cgreen18/Gas-Chromatography/README.md

# Gas Chromatography Capstone Project
The senior capstone project by Conor Green and Matt McPartlan to fulfill degree requirements for a B.S. in Electrical Engineering at Loyola Marymount University. The objective is to design a economic, diode based gas chromatography (GC) detector. As part of the requirements of a capstone project, we created a [website](https://gaschromatographycapstone.wordpress.com/), with weekly updates.

## Background on Gas Chromatography
Matt has written a great explanation and justification for this project in the document "[Introduction to Chromatography](https://github.com/cgreen18/Gas-Chromatography/blob/master/Documentation/Introduction%20to%20Chromatography.pdf)."

## Three Main Components 
* [Analog voltage measurement](https://github.com/cgreen18/Gas-Chromatography/tree/master/Voltage%20Measurement)
* [Heating](https://github.com/cgreen18/Gas-Chromatography/tree/master/Heating)
* [Analog to digital conversion (ADC)](https://github.com/cgreen18/Gas-Chromatography/tree/master/ADC)

## Additional Requirements
* [Graphical user interface (GUI)](https://github.com/cgreen18/Gas-Chromatography/tree/master/GUI)
* ~~Auto-injector~~

## Installation
There are automatic installation and configuration scripts, install.sh and config.sh, respectively, located in the [Installation Folder](https://github.com/cgreen18/Gas-Chromatography/tree/master/Installation)

## Current Prototype
IMAGE MISSING

## Old Prototype
The shell of an old Gow-mac GC.
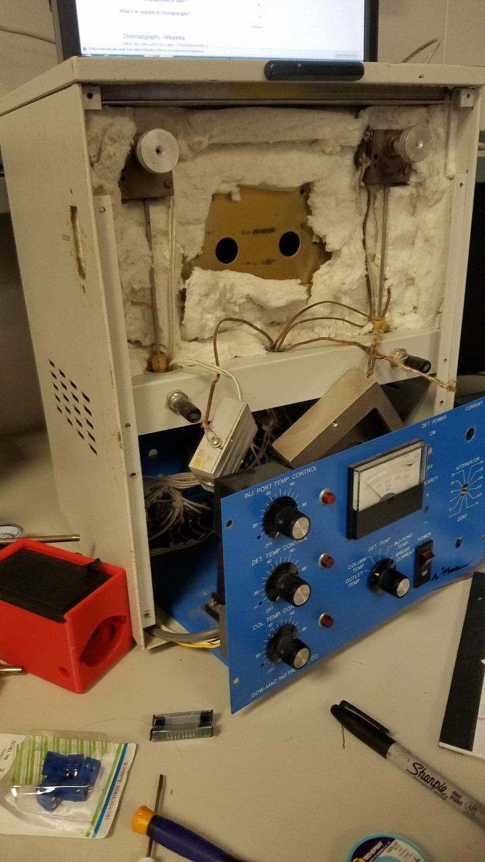
[picture p1: images/Galmac.jpg]
Gow-mac_Taken_Apart


## Team Member Biographies

#### Conor Green
> Conor Green is a Computer Engineering major at Loyola Marymount University, enrolled in the Honors College and pursuing a minor in Applied Mathematics. Every semester he has made Dean’s list and recently got invited and accepted into the engineering honor’s fraternity, Tau Beta Pi. Through the Honors department, Conor proposed, managed, and presented a $5000 research project on modifying the torque-slip characteristics of an induction motor through electro-plating that found significant results. Additionally, he was part of a team led by professor Dr. Huang to use computer vision to identify potholes from dash cam pictures in the Los Angeles area. Conor recently presented the induction motor and pothole research projects at This Is Honors and Undergraduate Research Symposium, respectively, at his university. In the summer of 2019 he participated in a NSF Research Experience for Undergraduates for Smart UAVs at Auburn University to model the interior of a building through Flash LiDAR without GPS. The results were novel and a technical report was written and published in the Computer Science and Software Engineering department of AU. In his senior year at LMU, Conor’s capstone project was to devise a cheap, easy-to-use, air or nitrogen based gas chromatography instrument. He plans on pursuing graduate school in Electrical Engineering with the intention of earning a Ph.D.

> Conor has consistently worked various jobs since he turned sixteen, including multiple summers of full time work and private and volunteer tutoring (mainly mathematics.) He has worked at his university’s bike shop, the Cycling Lion, since its inception and is starting his second year as a manager. Outside of academics and work, Conor is the Vice-President of his university’s rugby team and has participated in the UAV national competition SAE Aero West. He speaks Spanish fluently through classes and talking with close friends. Conor studied abroad in Madrid, Spain, for a semester his sophomore year.

#### Matt McPartlan
* coming shortly

## Acknowledgments
We would like to thank the Electrical Engineering and Computer Science and Chemistry departments at Loyola Marymount University for funding and support throughout the process. We would like to thank Dr. Hossein Asghari and Dr. Robert Senter for their advice and support as mentors. In particular, Dr. Senter has been on-board with the project since the inception 2 years ago and has provided tremendous help throughout.
