cgreen18/Gas-Chromatography/GUI/README.md

# GUI
Main folder for the software supporting the GC instrument.
This folder will probably moved to a folder with a better name in the final version.

### Versions
|Version | Date | Features |
|:---|:---|:---|
| 1.0 | 24 November 2019 | Initial Creation. |
| [2.0](https://github.com/cgreen18/Gas-Chromatography/tree/master/GUI/2.0) | 21 April 2020 | Successfully graphs live data with play button, graphs it live, saves images and .gc files, and clears. Basic, minimum GC supporting software. |
| [3.0](https://github.com/cgreen18/Gas-Chromatography/tree/master/GUI/3.0) | 24 April 2020 | Arduino serial interface. Temperature control and feedback thread. Normalize, integrate, and clean time menu functions. |
| 3.0+ | __future__ | Wrap up open parsing, data format, peaks. |
