cgreen18/Gas-Chromatography/Heating/README.md

# Oven, Injector, and Detector Heating Control

Increasing Delay gif

Example of Reducing Power Delivered to Element

## Breakdown of the System

### Triac Dimmer
Two [RoboDyn AC Light Dimmer](https://robotdyn.com/ac-light-dimmer-module-1-channel-3-3v-5v-logic-ac-50-60hz-220v-110v.html) were used to heat the elements: one dimmer for the oven and the other for the injector and detector together. This modules are triac based and as such, can clip the positive and negative waveforms. When the source voltage crosses zero, an interrupt is signalled for the microcontroller as seen in purple in the figure below. In this interrupt routine, the MCU delays some time then sends an ~8.33uS square pulse that allows the module to output the voltage to the load for the remainder of the wave as seen in green and blue in the figure below. 

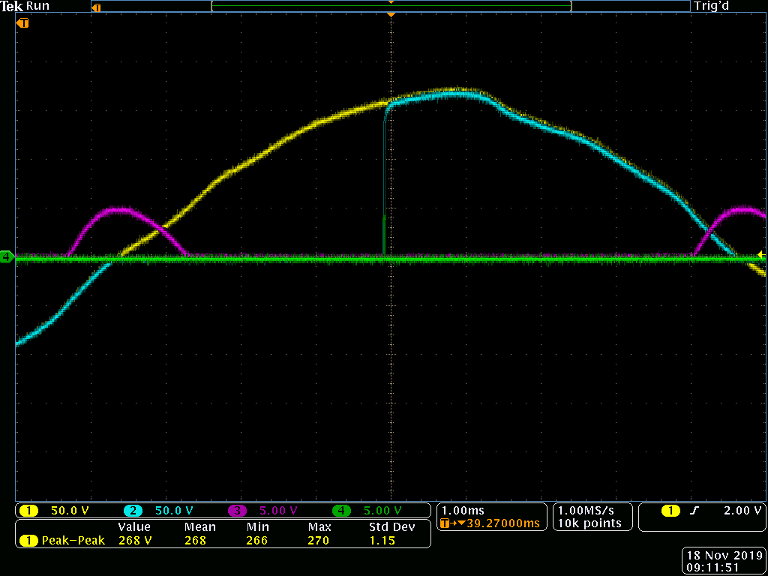
[picture p2: Heating/images/GC_TriacClipping_Oscilloscope_3.png]
Example Clip Oscilloscope


Legend:
* Yellow - Wall voltage = 120V @ 60Hz
* Blue - Load (heating element) voltage
* Purple - Zero-cross
* Green - Trigger square pulse

### Estimating Temperature
The voltage across the thermocouples is amplified by ~250 by an [LM358N](http://www.ti.com/product/LM358-N) as seen in the figure below.

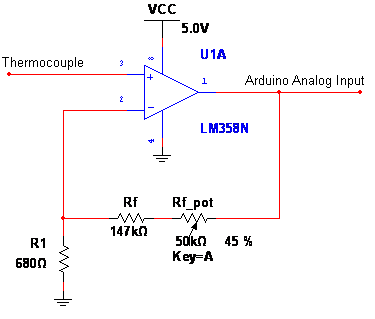
[picture p3: Heating/images/GC_ThermoAmp_SimpleCircuit_Snippet.png]
Non-inverting_amp


### PID Control
In order to achieve and maintain a desired temperature with little overshoot, a PID feedback loop was implemented with the triac output and the thermocouple temperature measurement. The output variable is the delay time before the square pulse is sent and the feedback variable is the amplified voltage from the thermocouples. The PID constants K<sub>p</sub>, K<sub>i</sub>, and K<sub>d</sub> will be tuned in the coming week.

PID_Diagram
Credit: Wikipedia @ [PID_Diagram_Link](https://en.wikipedia.org/wiki/PID_controller)
