cgreen18/Gas-Chromatography/ADC/README.md

# Directory for the Analog to Digital converter (ADC)
