cgreen18/Gas-Chromatography/GUI/4.0_Version/.images/README.md

# Current image directory set at the top of gc_gui.py
