cgreen18/Gas-Chromatography/Installation/Libraries.md

# Extra Libraries
### Important: All these must be install while the virtual environment is active
```
source /home/pi/.gc_venv/bin/activate
```

Update pip and tools for building a wheel (for use later)
```
pip install -U pip
pip install -U six wheel setuptools
```

Install some libraries
```
apt-get install libatlas-base-dev
```

More
```
pip3 install matplotlib
```

```
pip3 install pyyaml
```
