cgreen18/Gas-Chromatography/Installation/Extra.md

USB
```
sudo usermod -a -G dialout caravaggio
```
