cgreen18/Gas-Chromatography/(list of files, drawings)

Other design files:
Heating/Circuit Schematics/GC_ThermoAmp_SimpleCircuit_ConorMatt.ms13
Voltage Measurement/GC_AD620ANConfiguration.ms13
Voltage Measurement/GC_DiodeBiasing.ms13
Voltage Measurement/GC_ForwardVoltageDiffAmp.ms13
