cgreen18/Gas-Chromatography/Heating/three_element_heat_control.ino

/*  Title: three_element_heat_control.ino
 *  Author: Conor Green and Matt McPartlan
 *  Description: Reads injector, detector, and oven amplified thermocouple analog voltages... 
 *    and converts the values to temperature in Celcius. PID loop implemented using current...
 *    and target temperature.
 *  Usage: Upload to microcontroller with interrupt capability. Arduino Pro Micro 5V used.
 *  Version:
 *    1.0 - November 9 2019 - Initial creation.
 *    2.0 - November 11 2019 - Moved to one zero crossing interrupt
 */

// Constants - put in header/cpp later
// Max error from: minimum temp ~ 30C & max temp desired ~ 180 & small margin
float ERR_MAX = 160.0;

float K_P_OVEN = 0.98;
float K_I_OVEN = 0.01;
float K_D_OVEN = 0.01;

float K_P_INJ_DET = 0.98;
float K_I_INJ_DET = 0.01;
float K_D_INJ_DET = 0.01;

// Decision making variables
bool  x = true;

// Oven pins
int inter_oven = 2;
int triac_oven = 4;
int thermo_oven = A2;

// Oven variables (defaults)
unsigned int dim_oven = 1024;
float targ_oven = 150.0;
float temp_oven = 30.0;


// Injector and detector pins
int inter_inj_det = 3;
int triac_inj_det = 5;
int thermo_inj = A0;
int thermo_det = A1;

// Injector and detector variables
unsigned int dim_inj_det = 1024;
float targ_inj_det = 100.0;
float temp_inj = 30.0;
float temp_det = 30.0;

/*  Analog voltage to temperature conversion
 *  T = 58.3V + 39.2
 */

void setup() {
  Serial.begin(9600);
  
  pinMode(triac_inj_det,OUTPUT);
  pinMode(triac_oven,OUTPUT);
  attachInterrupt(digitalPinToInterrupt(inter_oven), zc_interrupt, RISING);
  //attachInterrupt(digitalPinToInterrupt(inter_inj_det), zc_inter_inj_det, RISING);
}

/*
void zc_inter_oven(){
  //Serial.println(dim_oven);
  dim_oven = 65*512;
  delayMicroseconds(dim_oven);
  digitalWrite(triac_oven,HIGH);
  delayMicroseconds(8.33);
  digitalWrite(triac_oven,LOW); 
}
*/

void zc_interrupt(){

  dim_oven = 5000;
  //dim_inj_det = (10000.0*/170);

  // oven >= inj_det + 8.33
  if(float diff = dim_oven - (dim_inj_det + 8.33) >=0){
    //float diff = dim_oven - (dim_inj_det + 8.33);

    Serial.println("Case 1");
    
    delayMicroseconds(dim_inj_det);
    digitalWrite(triac_inj_det,HIGH);
    delayMicroseconds(8.33);
    digitalWrite(triac_inj_det,LOW);
    delayMicroseconds(diff);
    digitalWrite(triac_oven,HIGH);
    delayMicroseconds(8.33);
    digitalWrite(triac_oven,LOW);
  }
  
  // inj_det + 8.33 >= oven > inj_det
  else if(float diff = dim_oven - dim_inj_det > 0){
    //float diff = dim_oven - dim_inj_det;
    
    Serial.println("Case 2");

    delayMicroseconds(dim_inj_det);
    digitalWrite(triac_inj_det,HIGH);
    delayMicroseconds(diff);
    digitalWrite(triac_oven,HIGH);
    delayMicroseconds(8.33-diff);
    digitalWrite(triac_inj_det,LOW);
    delayMicroseconds(diff);
    digitalWrite(triac_oven,LOW);
  }

  // inj_det >= oven +8.33
  else if(float diff = dim_inj_det - (dim_oven + 8.33) >= 0){
    //float diff = dim_inj_det - (dim_oven + 8.33);

    delayMicroseconds(dim_oven);
    digitalWrite(triac_oven,HIGH);
    delayMicroseconds(8.33);
    digitalWrite(triac_oven,LOW);
    delayMicroseconds(diff);
    digitalWrite(triac_inj_det,HIGH);
    delayMicroseconds(8.33);
    digitalWrite(triac_inj_det,LOW);    
  }

  // oven + 8.33 > inj_det >= oven 
  else if(float diff = dim_inj_det - dim_oven  >= 0){
    delayMicroseconds(dim_oven);
    digitalWrite(triac_oven,HIGH);
    delayMicroseconds(8.33-diff);
    digitalWrite(triac_inj_det,HIGH);
    delayMicroseconds(diff);
    digitalWrite(triac_oven,LOW);
    delayMicroseconds(8.33-diff);
    digitalWrite(triac_inj_det,LOW); 
  }
  
   
}

void update_temperatures(){
  int raw;
  raw = analogRead(thermo_oven);
  temp_oven = .284667*raw + 39.2;
  if(x){
    Serial.print("Oven temp: ");
    Serial.println(temp_oven);
  }
  raw = analogRead(thermo_inj);
  temp_inj = .284667*raw + 39.2;

  if(x){
    Serial.print("Injector temp: ");
    Serial.println(temp_inj);
  }

  raw = analogRead(thermo_det);
  temp_det = .284667*raw + 39.2;

  if(x){
    Serial.print("Detector temp: ");
    Serial.println(temp_det);
  }

  x = !x;
}

void update_dimming(){
  float err, p, i, d, u;
  
  // Oven
  err = targ_oven - temp_oven;

  
  p = K_P_OVEN*err;
  i = K_I_OVEN*err;
  d = K_D_OVEN*err;

  u = p + i + d;
  
  dim_oven = (int) ((10.0*1024.0/ERR_MAX)*(ERR_MAX-err));

  if(dim_oven >= 4000){
    dim_oven = 4000;
  }

  /*
  Serial.print("Oven Error: ");
  Serial.println(err);
  Serial.print("u: ");
  Serial.println(u);
  Serial.println("Oven microsecond delay: ")
  Serial.println(dim_oven);
  */

  // Injector and detector
  // Weighted average between injector and detector
  err = targ_inj_det - (0.2*temp_det + 0.8*temp_inj);

  p = K_P_OVEN*err;
  i = K_I_OVEN*err;
  d = K_D_OVEN*err;

  u = p + i + d;
  dim_inj_det = (int) ((10.0*1024.0/ERR_MAX)*(ERR_MAX-err));

  if(dim_inj_det >= 12000){
    dim_inj_det = 12000;
  }

  Serial.print("Inj_det Error: ");
  Serial.println(err);
  Serial.print("u: ");
  Serial.println(u);
  Serial.println("Injector and detector microsecond delay: ");
  Serial.println(dim_inj_det);
  
}


void loop() {
  while (true){
    update_temperatures();
    update_dimming();
  }
}
