cgreen18/Gas-Chromatography/(commit log)

2019-09-14 Multisim Circuit Schematics of Sensor Amplifier
    [GC_Instrumental_Amp.ms11, GC_Sensor_Preamp.ms11, GC_Sensor_Total.ms11]
2019-10-22 arduino project of feedback temperature control
2019-11-10 currently debugging
2019-11-12 Create Voltage Measurement
2019-11-12 testing atom
    [GC_Instrumental_Amp.ms11, GC_Sensor_Preamp.ms11, GC_Sensor_Total.ms11, GC_ThermoAmp_SimpleCircuit_ConorMatt.ms13]
2019-11-17 Circuit Schematics
    [GC_AD620ANConfiguration.ms13, GC_DiodeBiasing.ms13, GC_ForwardVoltageDiffAmp.ms13]
2019-11-18 chaing file structure
    [GC_ThermoAmp_SimpleCircuit_ConorMatt.ms13]
2019-11-18 Changing files
    [GC_ThermoAmp_SimpleCircuit_ConorMatt.ms13]
2019-11-25 Current progress
2020-02-18 on track w master
2020-02-21 printing debugging
2020-04-01 removed debuggin prints
2020-04-08 wheel setuptools
2020-04-11 pretty printf
2020-04-20 trying multiprocessing for play button
2020-04-20 debugging prints
2020-04-21 debug print
2020-04-21 stop evt print
2020-04-21 printing debugs
2020-04-21 debuggin prints
2020-04-21 frame pass
2020-04-21 switched close order
2020-04-21 bind plot button
2020-04-21 added plotting thread
2020-04-22 temperature serial
2020-04-22 text controls to set temperature set
2020-04-23 print ebug
2020-04-23 remove prints
2020-04-23 removed and added prints
2020-04-23 print debug
2020-04-25 err and slower temp thread
2020-04-25 out prints
2020-04-25 current imdir
2020-04-25 button test
2020-04-26 print debugs
2020-04-26 larger frame
2020-04-26 test frame size
2020-04-26 detector temperature -> injector
2020-04-27 removed print
2020-04-27 forgot to set volt in mov_,ean_
